epfl-cs358/2024sp-2d-plotter/README.md

# Individual Project Spring 2024: 2D Plotter

Open the file
[Hardware/3D_Files/2024-spring-plotter.step](Hardware/3D\_Files/2024-spring-plotter.step)
in Fusion 360.
See the course manual for more info.

[Here](Summer2023.md) is more on a prototype built in Summer 2023.
