epfl-cs358/2024sp-2d-plotter/Hardware/Pictures/base plate.png

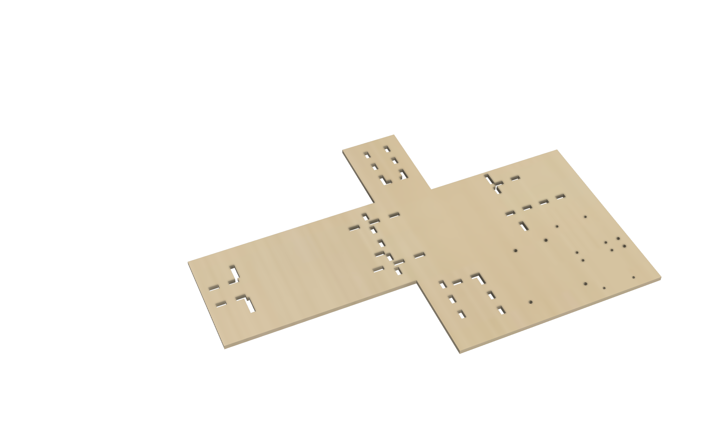
Hardware/Pictures/base plate.png
