epfl-cs358/2024sp-2d-plotter/Hardware/Pictures/bottom holder.png

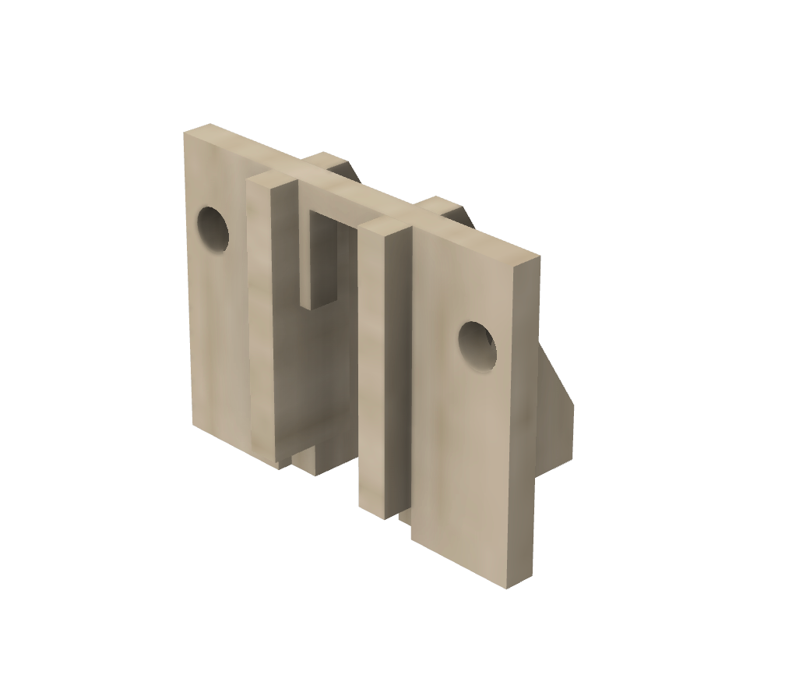
Hardware/Pictures/bottom holder.png
