epfl-cs358/2024sp-2d-plotter/Hardware/Pictures/draw plate.png

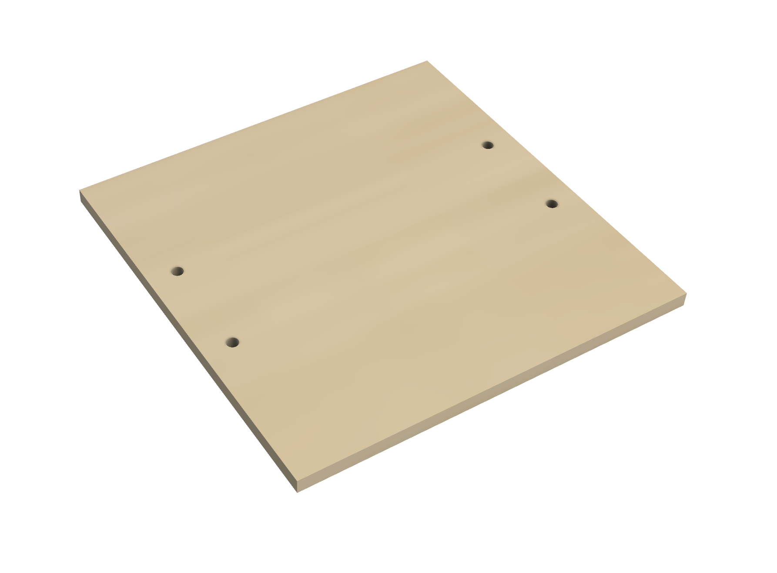
Hardware/Pictures/draw plate.png
