epfl-cs358/2024sp-2d-plotter/Hardware/Pictures/left holder.png

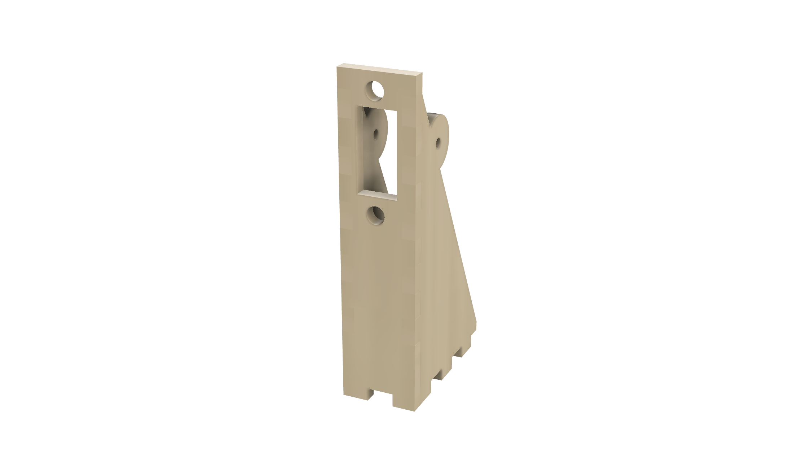
Hardware/Pictures/left holder.png
