epfl-cs358/2024sp-2d-plotter/Hardware/Pictures/middle holder.png

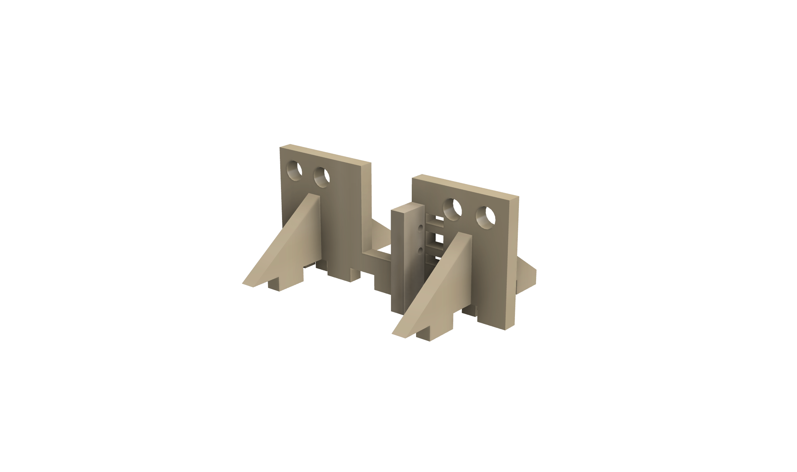
Hardware/Pictures/middle holder.png
