epfl-cs358/2024sp-2d-plotter/Hardware/Pictures/Overview.png

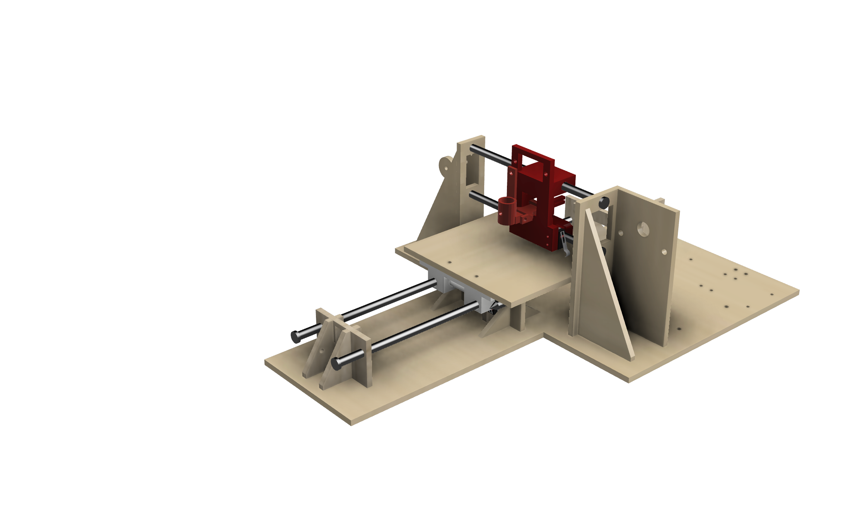
Hardware/Pictures/Overview.png
