epfl-cs358/2024sp-2d-plotter/Hardware/Pictures/Pen holder 1.png

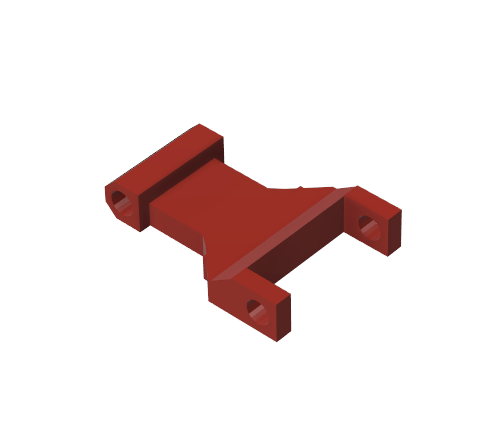
Hardware/Pictures/Pen holder 1.png
