epfl-cs358/2024sp-2d-plotter/Hardware/Pictures/pen holder 2.png

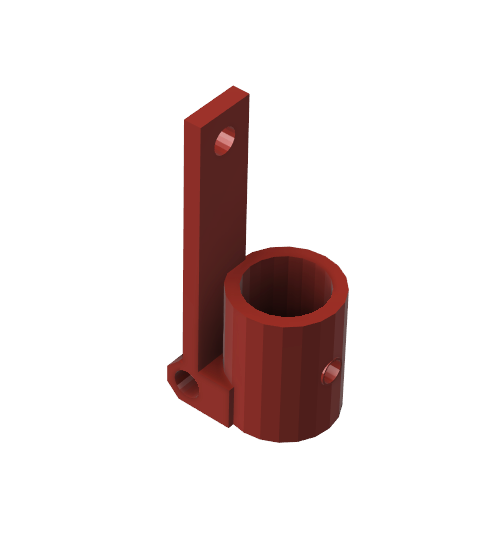
Hardware/Pictures/pen holder 2.png
