epfl-cs358/2024sp-2d-plotter/Hardware/Pictures/pen slider.png

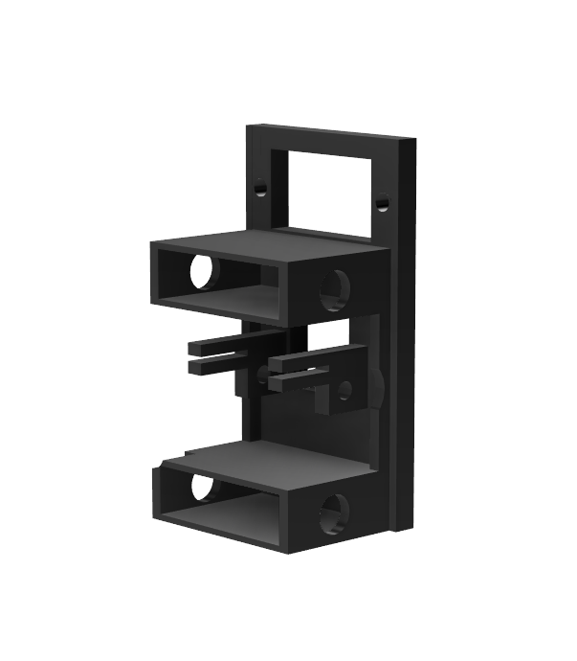
Hardware/Pictures/pen slider.png
