epfl-cs358/2024sp-2d-plotter/Hardware/Pictures/plate holder 1.png

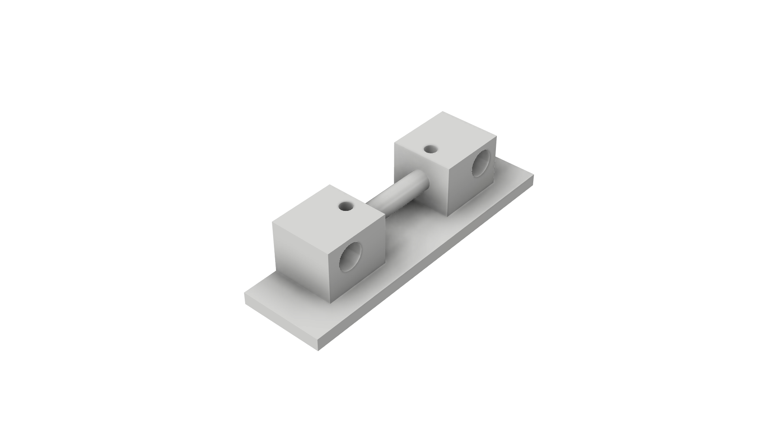
Hardware/Pictures/plate holder 1.png
