epfl-cs358/2024sp-2d-plotter/Hardware/Pictures/right holder.png

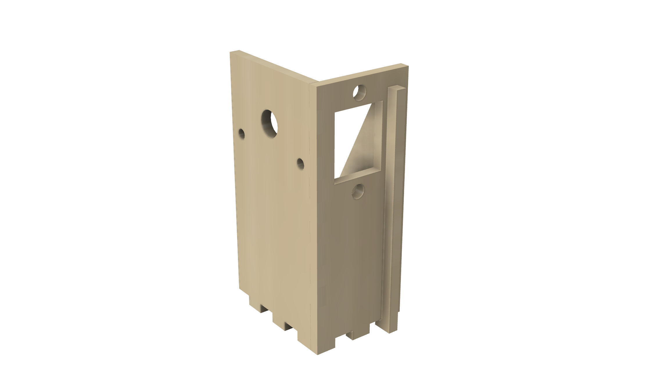
Hardware/Pictures/right holder.png
