epfl-cs358/2024sp-2d-plotter/Hardware/Pictures/top holder.png

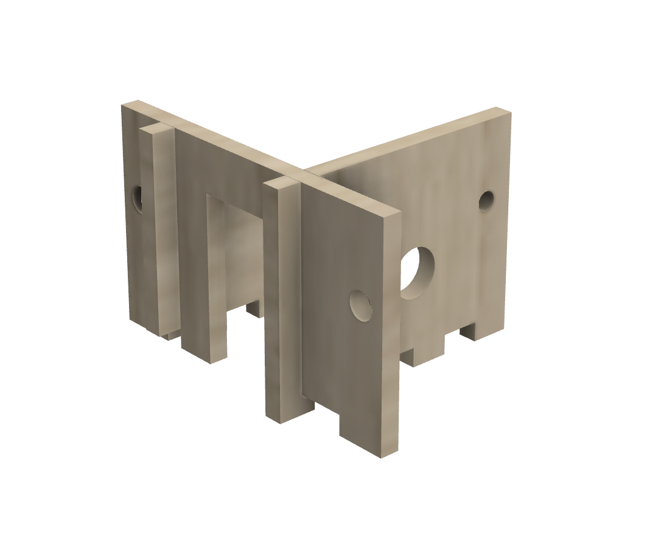
Hardware/Pictures/top holder.png
