epfl-cs358/2024sp-2d-plotter/Hardware/3D_Files/2024-spring-plotter.step

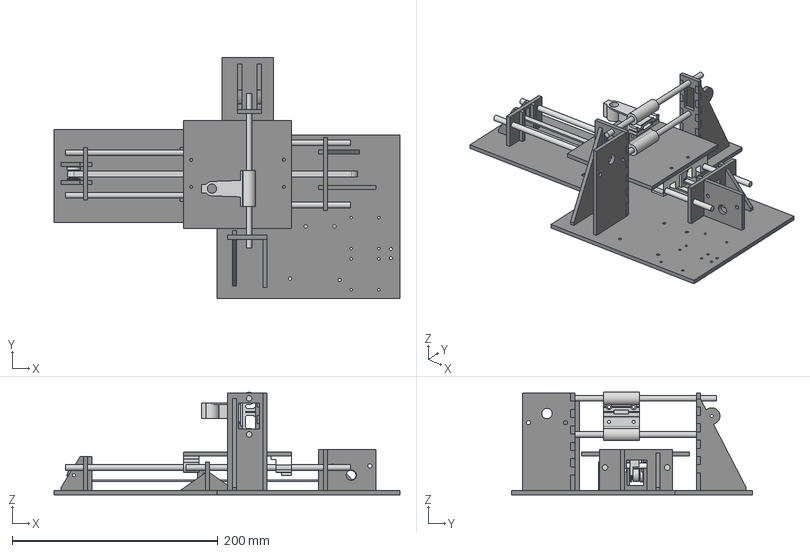
[picture p19: CAD file, 2024-02-15]
Hardware/3D_Files/2024-spring-plotter.step
336.0 x 234.0 x 99.6 mm
TopRailHolder
BottomRailHolder
RightRailHolder
LeftRailHolder
MiddleHolder
PlateHolderNarrow
BasePlankNew
PenHolderSlider
Draw plate
Belt
PlateHolderWide
BlindPulley
Nails
