epfl-cs358/2024sp-2d-plotter/Hardware/3D_Files/dxf/base_plate.dxf

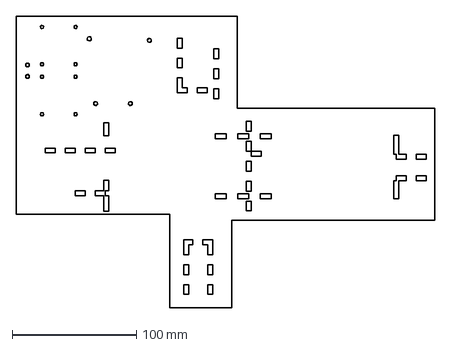
[picture p20: CAD file, 2024-02-15]
Hardware/3D_Files/dxf/base_plate.dxf
336.0 x 234.0 mm
