epfl-cs358/2024sp-2d-plotter/Hardware/3D_Files/stl-2023-summer/pen holder slider/phs1.stl

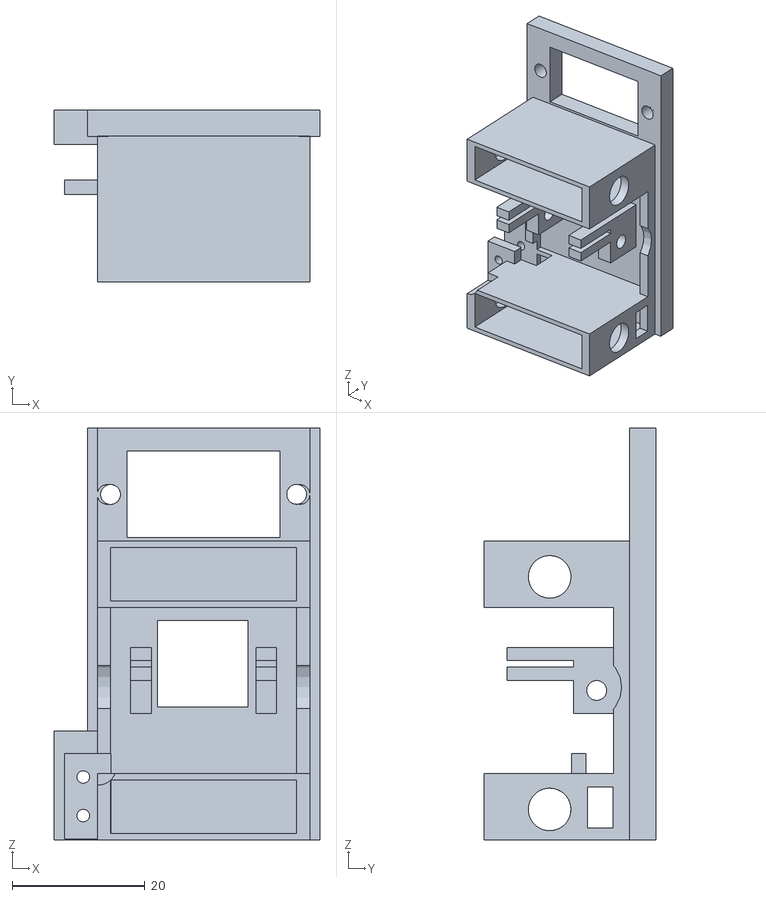
[picture p21: CAD file, 2023-06-12]
Hardware/3D_Files/stl-2023-summer/pen holder slider/phs1.stl
40.0 x 26.0 x 62.0
