epfl-cs358/2024sp-2d-plotter/Hardware/3D_Files/stl-2023-summer/plate holders/ph1.stl

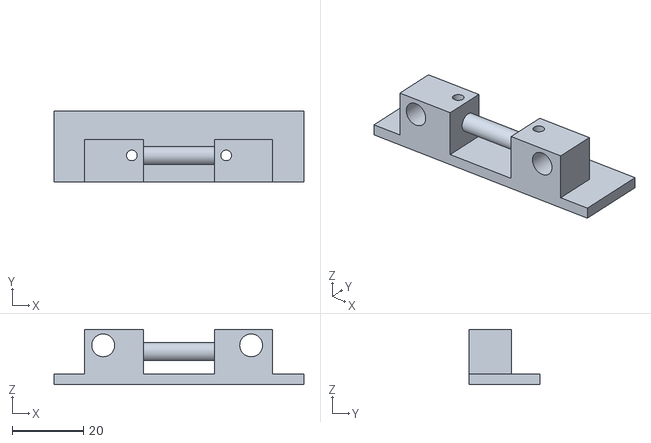
[picture p22: CAD file, 2023-06-12]
Hardware/3D_Files/stl-2023-summer/plate holders/ph1.stl
70.0 x 20.0 x 15.5
