epfl-cs358/2024sp-2d-plotter/Hardware/3D_Files/stl/BlindPulley.stl

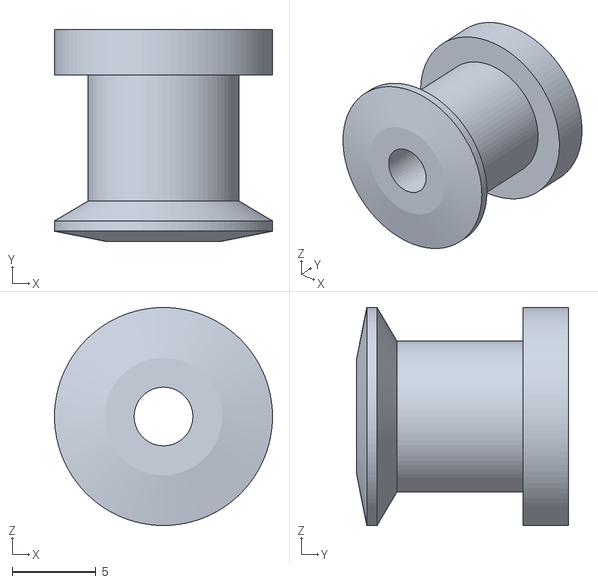
[picture p23: CAD file, 2024-02-15]
Hardware/3D_Files/stl/BlindPulley.stl
13.0 x 12.6 x 13.0
