epfl-cs358/2024sp-2d-plotter/Hardware/3D_Files/2023-summer-plotter.step

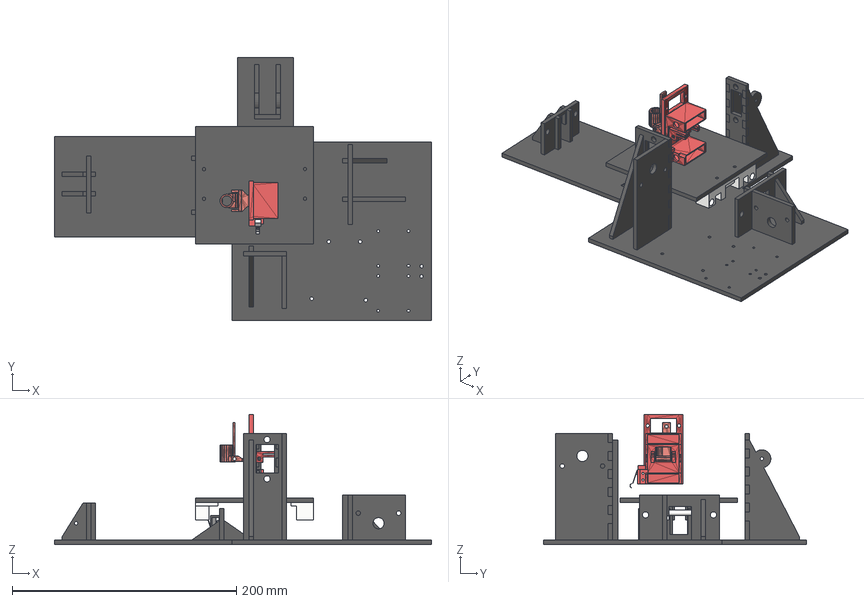
[picture p24: CAD file, 2023-06-12]
Hardware/3D_Files/2023-summer-plotter.step
336.0 x 234.0 x 116.0 mm
Top rail holder
Bottom rail holder
Right rail holder
Left rail holder
Middle holder (1)
Plate holder (2)
Plate holder (1) (1)
Switch v1 x 2
Base plank
pen holder
Draw plate
