epfl-cs358/2024sp-2d-plotter/Hardware/3D_Files/dxf/bottom_face.dxf

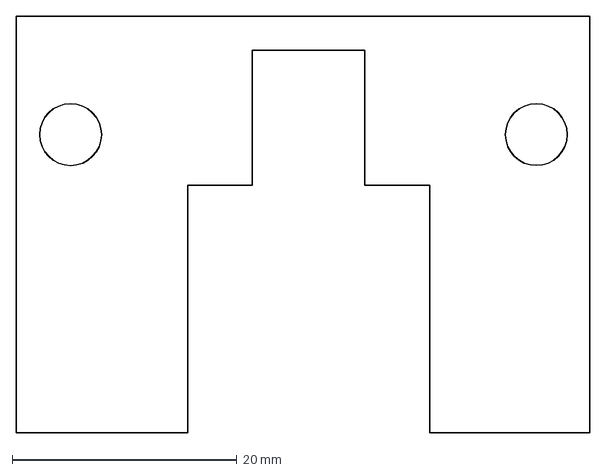
[picture p25: CAD file, 2024-02-15]
Hardware/3D_Files/dxf/bottom_face.dxf
51.0 x 37.0 mm
