epfl-cs358/2024sp-2d-plotter/Hardware/3D_Files/stl-2023-summer/pen holder slider/phs3.stl

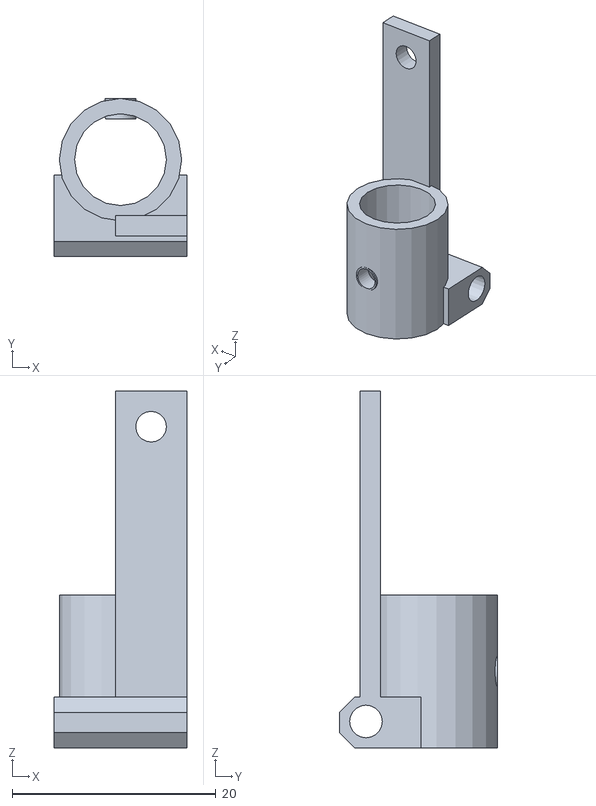
[picture p26: CAD file, 2023-06-12]
Hardware/3D_Files/stl-2023-summer/pen holder slider/phs3.stl
13.0 x 15.5 x 35.0
