epfl-cs358/2024sp-2d-plotter/Hardware/3D_Files/stl/PenHolderRigid.stl

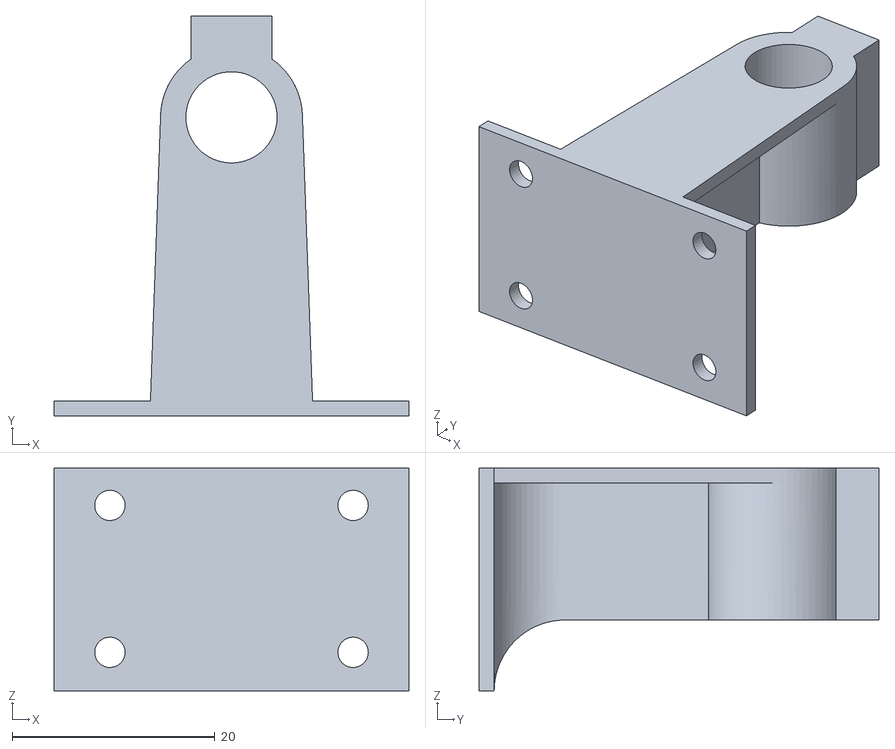
[picture p28: CAD file, 2024-02-15]
Hardware/3D_Files/stl/PenHolderRigid.stl
35.0 x 39.5 x 22.0
