epfl-cs358/2024sp-2d-plotter/Hardware/3D_Files/dxf/left_side.dxf

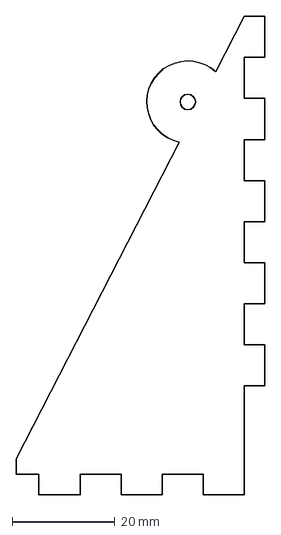
[picture p29: CAD file, 2023-06-12]
Hardware/3D_Files/dxf/left_side.dxf
48.5 x 93.2 mm
