epfl-cs358/2024sp-2d-plotter/Hardware/3D_Files/stl-2023-summer/pen holder slider/phs2.stl

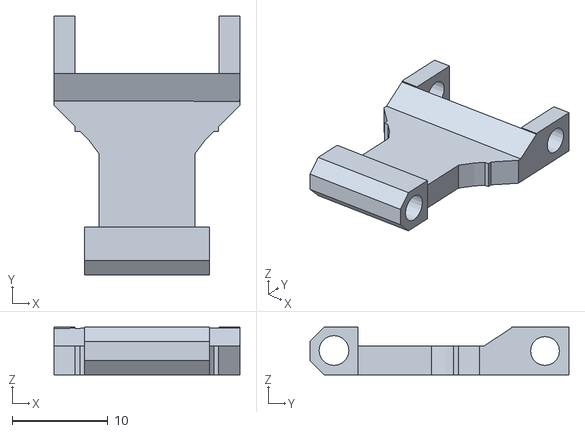
[picture p30: CAD file, 2023-06-12]
Hardware/3D_Files/stl-2023-summer/pen holder slider/phs2.stl
19.3 x 27.0 x 5.00
