epfl-cs358/2024sp-2d-plotter/Hardware/3D_Files/stl/PenHolderSlider.stl

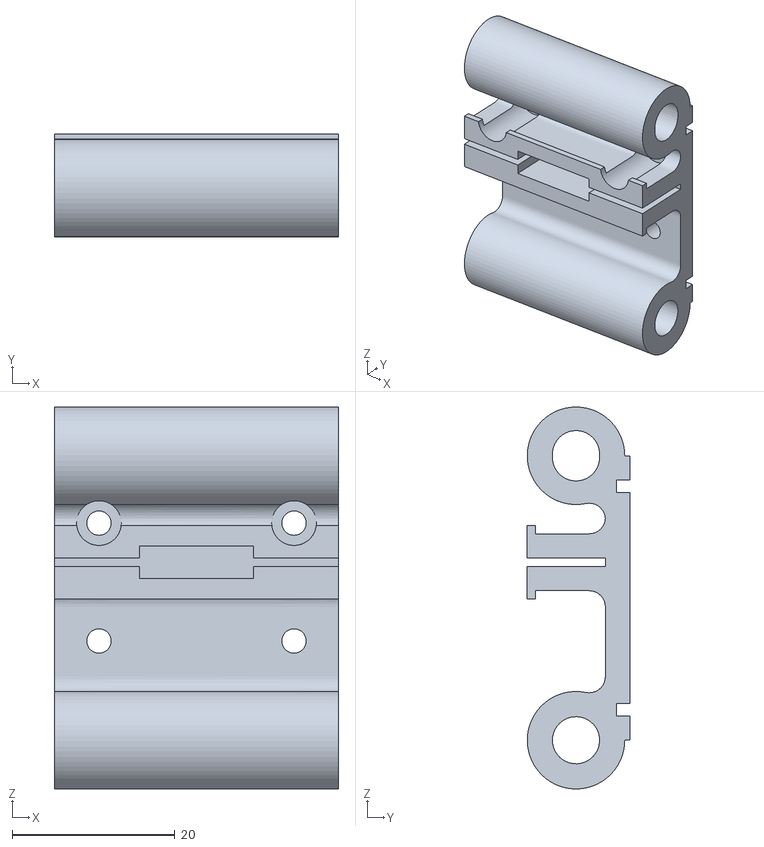
[picture p31: CAD file, 2024-02-15]
Hardware/3D_Files/stl/PenHolderSlider.stl
35.0 x 12.6 x 47.0
