epfl-cs358/2024sp-2d-plotter/Hardware/3D_Files/dxf/top_face.dxf

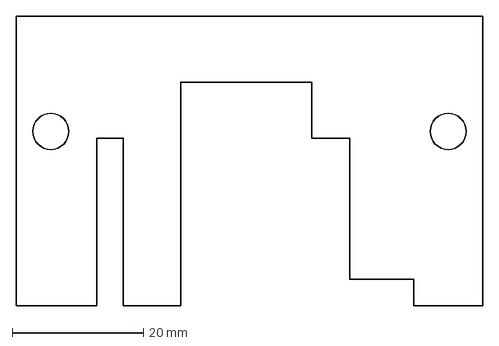
[picture p32: CAD file, 2023-06-12]
Hardware/3D_Files/dxf/top_face.dxf
71.0 x 44.0 mm
