epfl-cs358/2024sp-2d-plotter/Hardware/3D_Files/stl/PlateHolderWide.stl

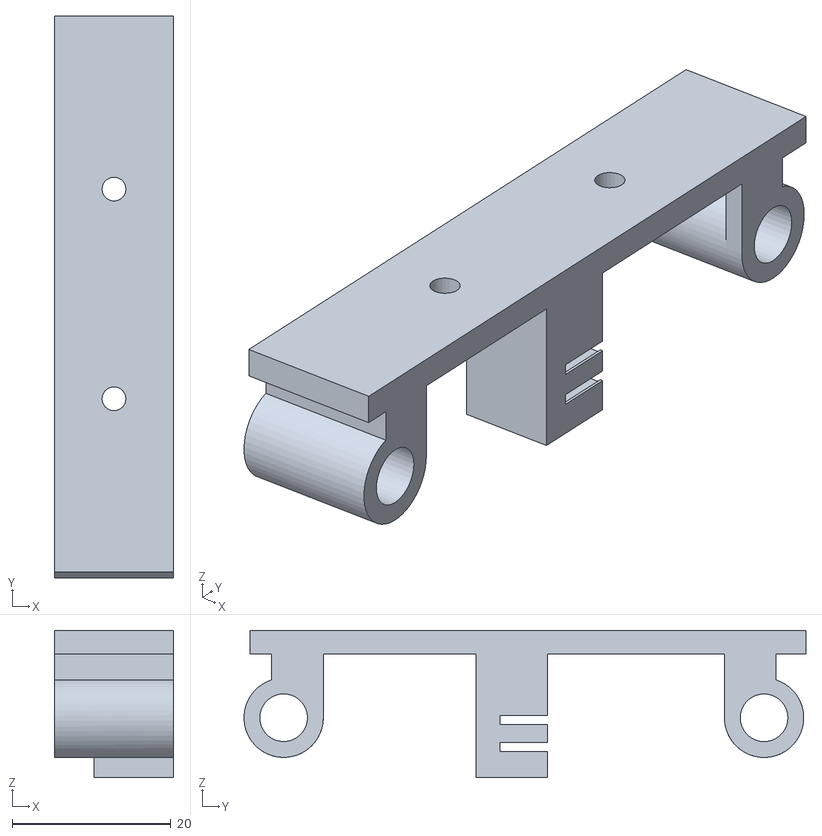
[picture p33: CAD file, 2024-02-15]
Hardware/3D_Files/stl/PlateHolderWide.stl
15.0 x 70.8 x 18.5
