epfl-cs358/2024sp-2d-plotter/Hardware/3D_Files/dxf/right_side1.dxf

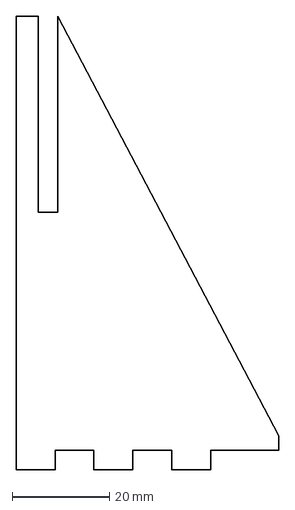
[picture p34: CAD file, 2023-06-12]
Hardware/3D_Files/dxf/right_side1.dxf
54.0 x 93.3 mm
