epfl-cs358/2024sp-2d-plotter/Hardware/3D_Files/stl/PlateHolderNarrow.stl

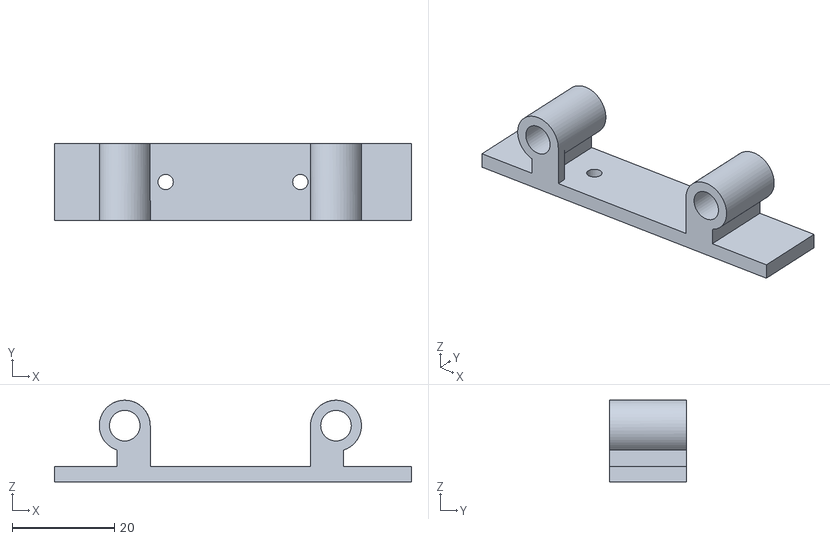
[picture p35: CAD file, 2024-02-15]
Hardware/3D_Files/stl/PlateHolderNarrow.stl
70.0 x 15.0 x 16.0
