epfl-cs358/2024sp-2d-plotter/Hardware/3D_Files/dxf/middle_face.dxf

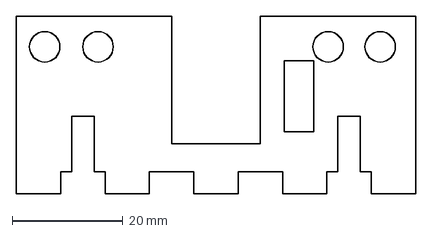
[picture p36: CAD file, 2023-06-12]
Hardware/3D_Files/dxf/middle_face.dxf
72.0 x 32.0 mm
