epfl-cs358/2024sp-2d-plotter/Hardware/3D_Files/dxf/bottom_side.dxf

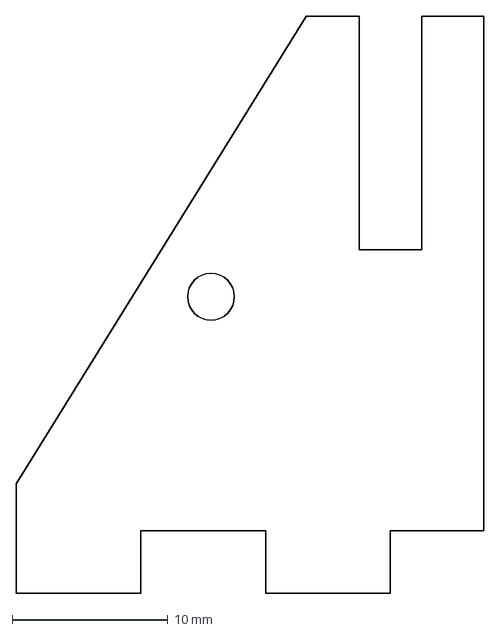
[picture p38: CAD file, 2023-06-12]
Hardware/3D_Files/dxf/bottom_side.dxf
30.0 x 37.0 mm
