epfl-cs358/2024sp-2d-plotter/Hardware/3D_Files/dxf/right_face.dxf

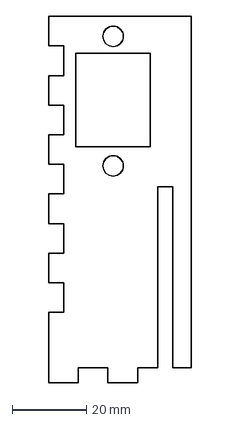
[picture p39: CAD file, 2023-06-12]
Hardware/3D_Files/dxf/right_face.dxf
38.5 x 99.0 mm
