epfl-cs358/2024sp-2d-plotter/Hardware/3D_Files/dxf/top_side2.dxf

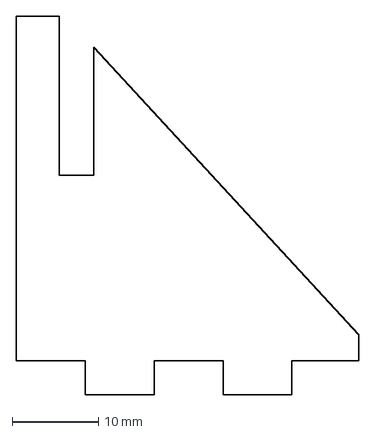
[picture p40: CAD file, 2023-06-12]
Hardware/3D_Files/dxf/top_side2.dxf
39.7 x 44.0 mm
