epfl-cs358/2024sp-2d-plotter/Hardware/3D_Files/dxf/left_face.dxf

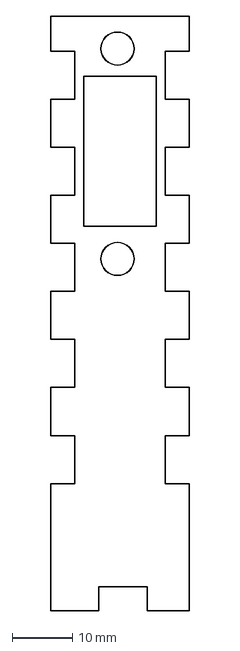
[picture p41: CAD file, 2023-06-12]
Hardware/3D_Files/dxf/left_face.dxf
23.0 x 99.0 mm
