epfl-cs358/2024sp-2d-plotter/Hardware/3D_Files/dxf/middle_switch.dxf

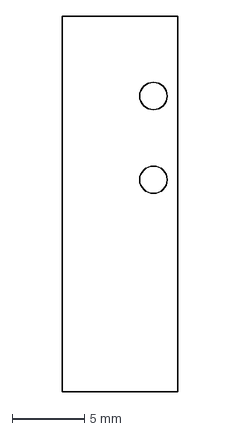
[picture p42: CAD file, 2023-06-12]
Hardware/3D_Files/dxf/middle_switch.dxf
8.00 x 26.0 mm
