epfl-cs358/2024sp-2d-plotter/Hardware/3D_Files/dxf/middle_side.dxf

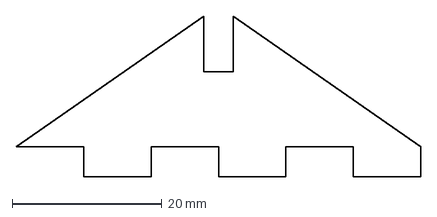
[picture p43: CAD file, 2023-06-12]
Hardware/3D_Files/dxf/middle_side.dxf
54.0 x 21.4 mm
