epfl-cs358/2024sp-2d-plotter/Hardware/3D_Files/dxf/draw_plate.dxf

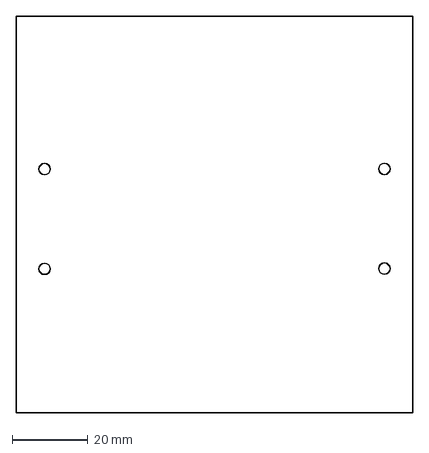
[picture p44: CAD file, 2023-06-12]
Hardware/3D_Files/dxf/draw_plate.dxf
105.0 x 105.0 mm
