epfl-cs358/2024sp-2d-plotter/Hardware/3D_Files/dxf/right_side2.dxf

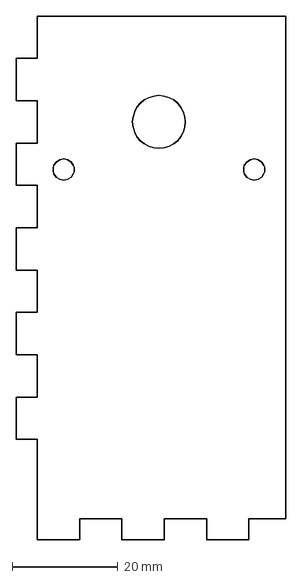
[picture p45: CAD file, 2023-06-12]
Hardware/3D_Files/dxf/right_side2.dxf
51.0 x 99.0 mm
