epfl-cs358/2024sp-2d-plotter/(commit log)

2023-06-12 Added Hardware and Software folders
    [base_plate.dxf, bottom_face.dxf, bottom_side.dxf, draw_plate.dxf, left_face.dxf, left_side.dxf, middle_face.dxf, middle_side.dxf]
2023-06-12 Added step file
    [MIT-2DPlotter.step, phs1.stl]
2023-08-28 Updated readme for servo images
2023-08-28 Renamed wiring diagrams
2023-08-28 Update README.md Added wiring diagram
2024-02-15 updated files
    [2023-summer.step, base_plate.dxf, bottom_face.dxf, ph1.stl, ph2.stl, phs1.stl, phs2.stl, phs3.stl]
2024-02-15 stl names cleaned up
    [PenHolderRigid.stl, PlateHolderWide.stl]
2024-02-15 added blind pulley
    [BlindPulley.stl]
